cracked-machine/GatedMXREnvelopeFilter/docs/GatedEnvelopeFilter_Schematic.pdf

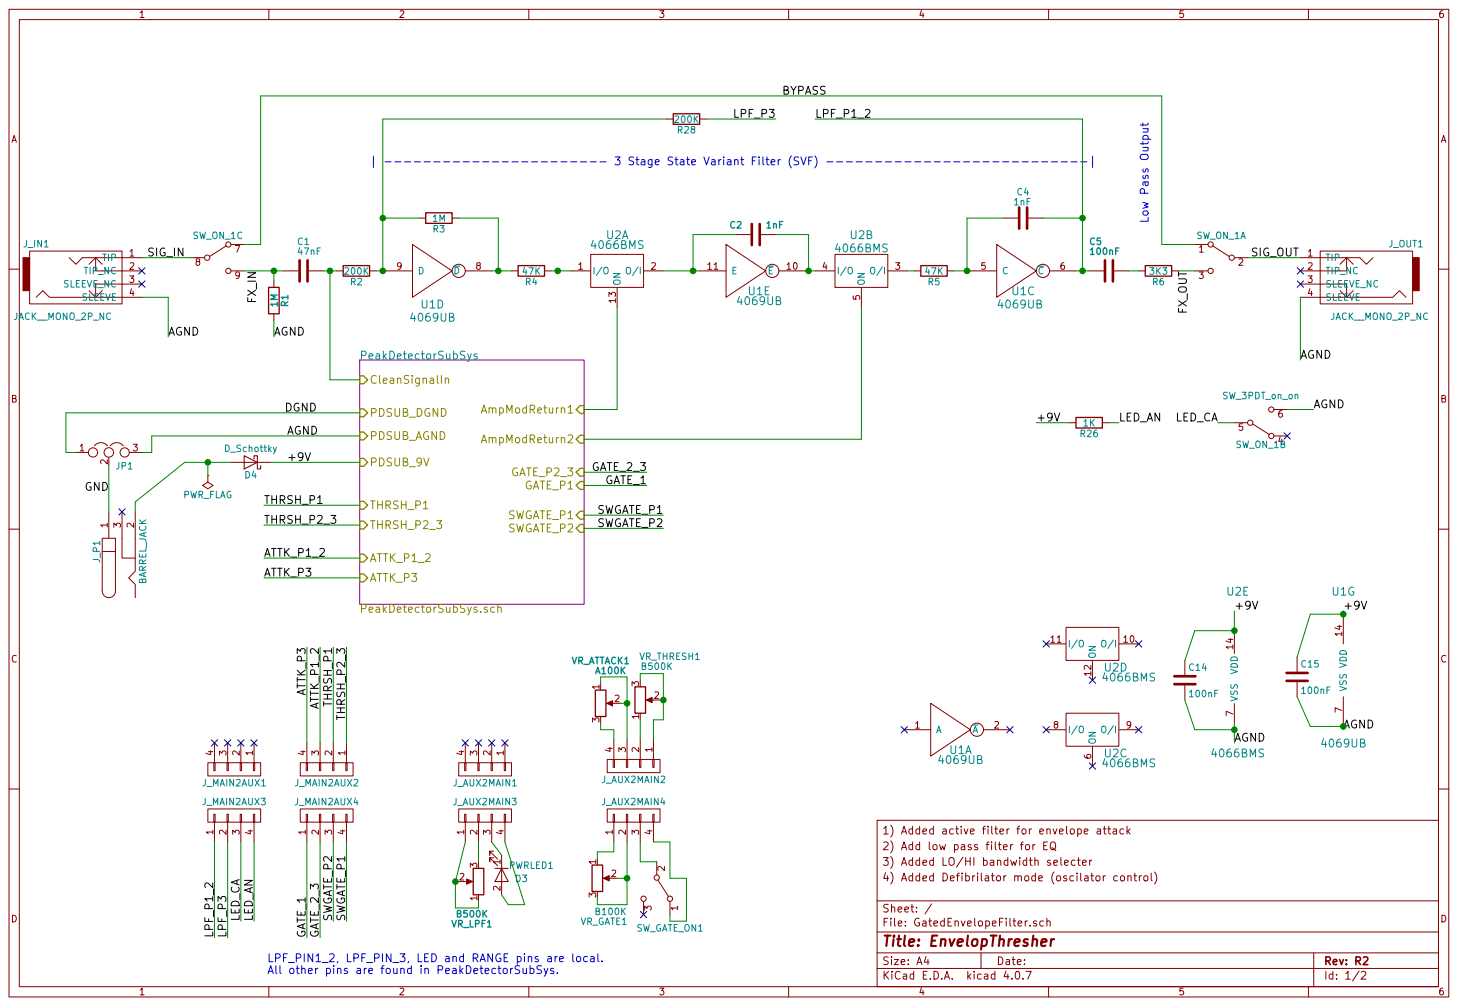
[picture p1: page 1]

1) Added active filter for envelope attack
2) Add low pass filter for EQ
3) Added LO/HI bandwidth selecter
File: GatedEnvelopeFilter.sch Sheet: / 4) Added Defibrilator mode (oscilator control)

LPF_PIN1_2, LPF_PIN_3, LED and RANGE pins are local.

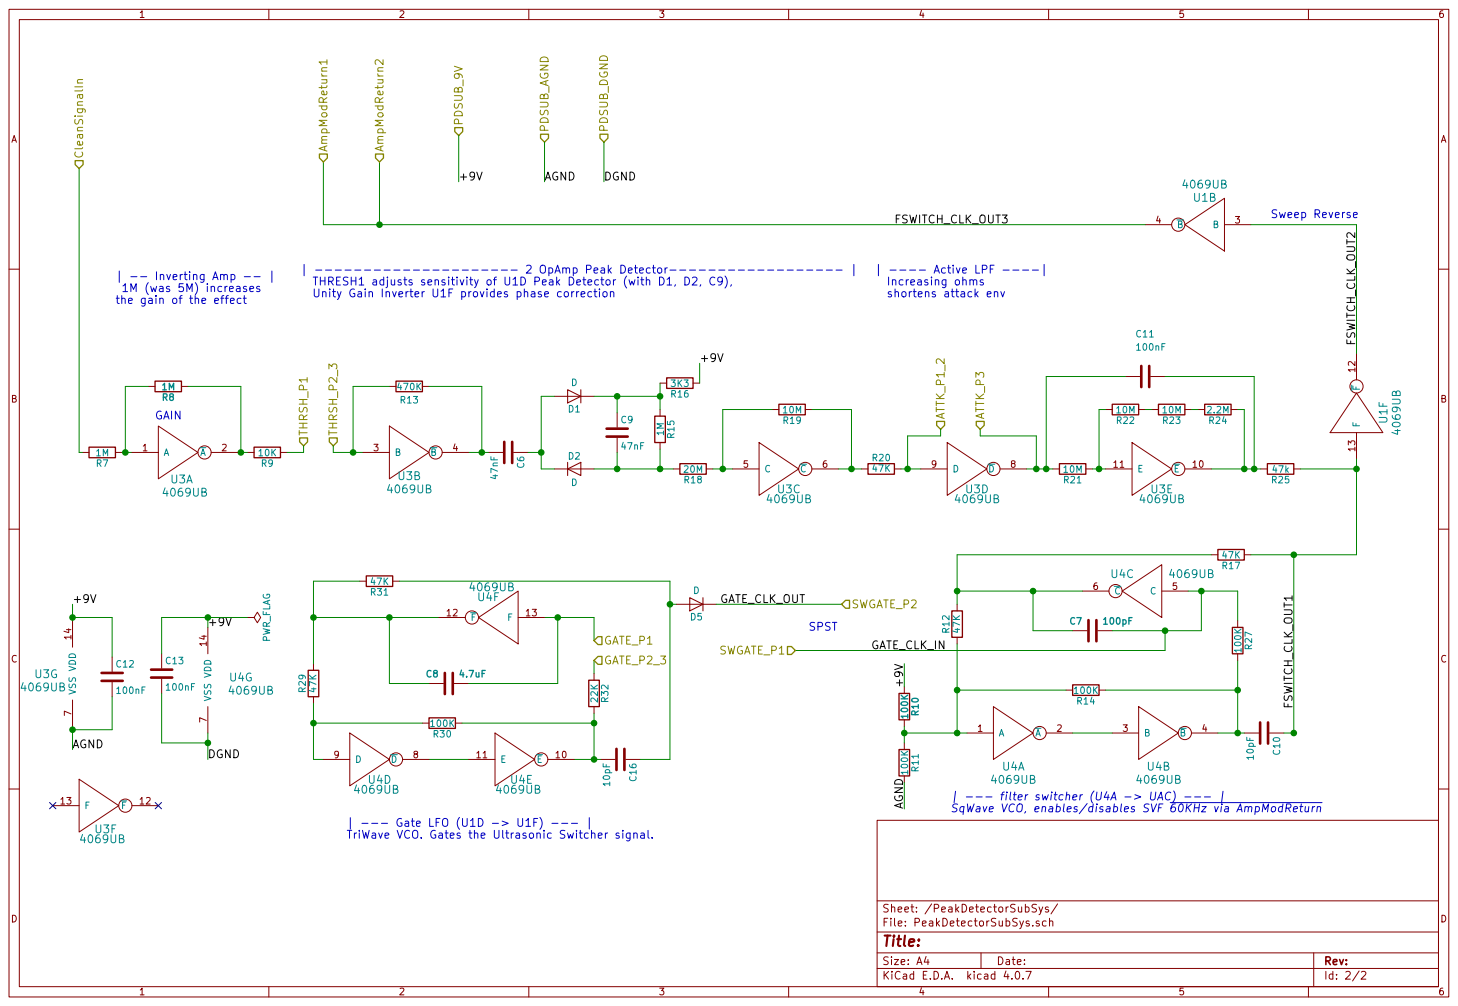
[picture p2: page 2]

-- Inverting Amp --
1M (was 5M) increases
the gain of the effect

--------------------- 2 OpAmp Peak Detector------------------
THRESH1 adjusts sensitivity of U1D Peak Detector (with D1, D2, C9),
Unity Gain Inverter U1F provides phase correction

--- filter switcher (U4A -> UAC) ---
SqWave VCO, enables/disables SVF 60KHz via AmpModReturn

--- Gate LFO (U1D -> U1F) ---
TriWave VCO. Gates the Ultrasonic Switcher signal.
