cracked-machine/GatedMXREnvelopeFilter/docs/GatedEnvelopeFilter-brdBack.pdf

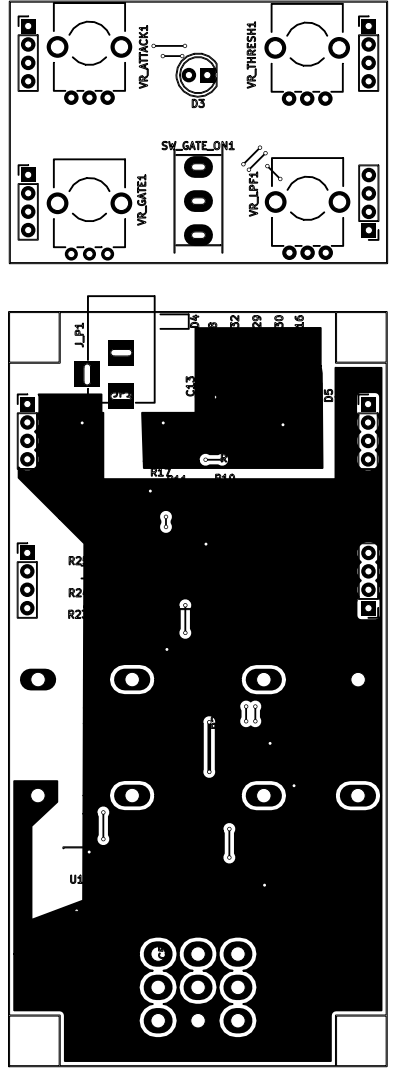
[picture p3: page 1]
