cracked-machine/GatedMXREnvelopeFilter/docs/GatedEnvelopeFilter-brdFront.pdf

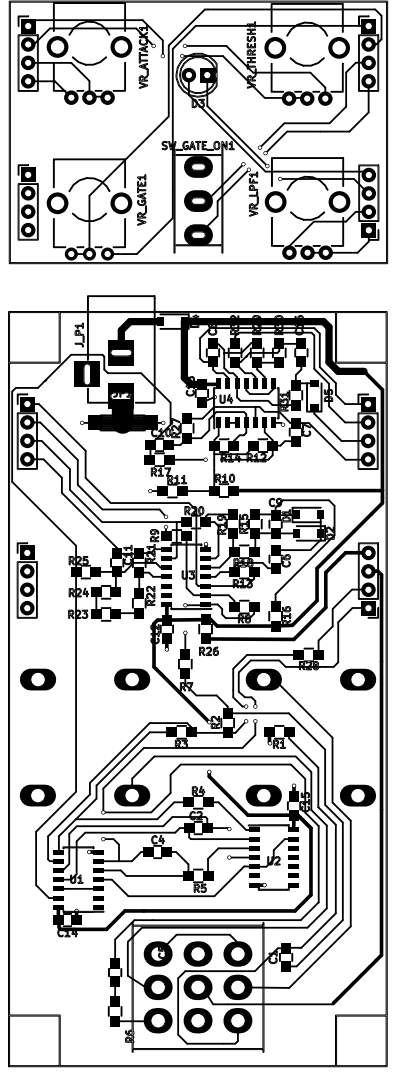
[picture p4: page 1]
