cracked-machine/GatedMXREnvelopeFilter/GatedEnvelopeFilter.kicad_pcb

## KiCad design GatedEnvelopeFilter.kicad_pcb (2018-03-17)

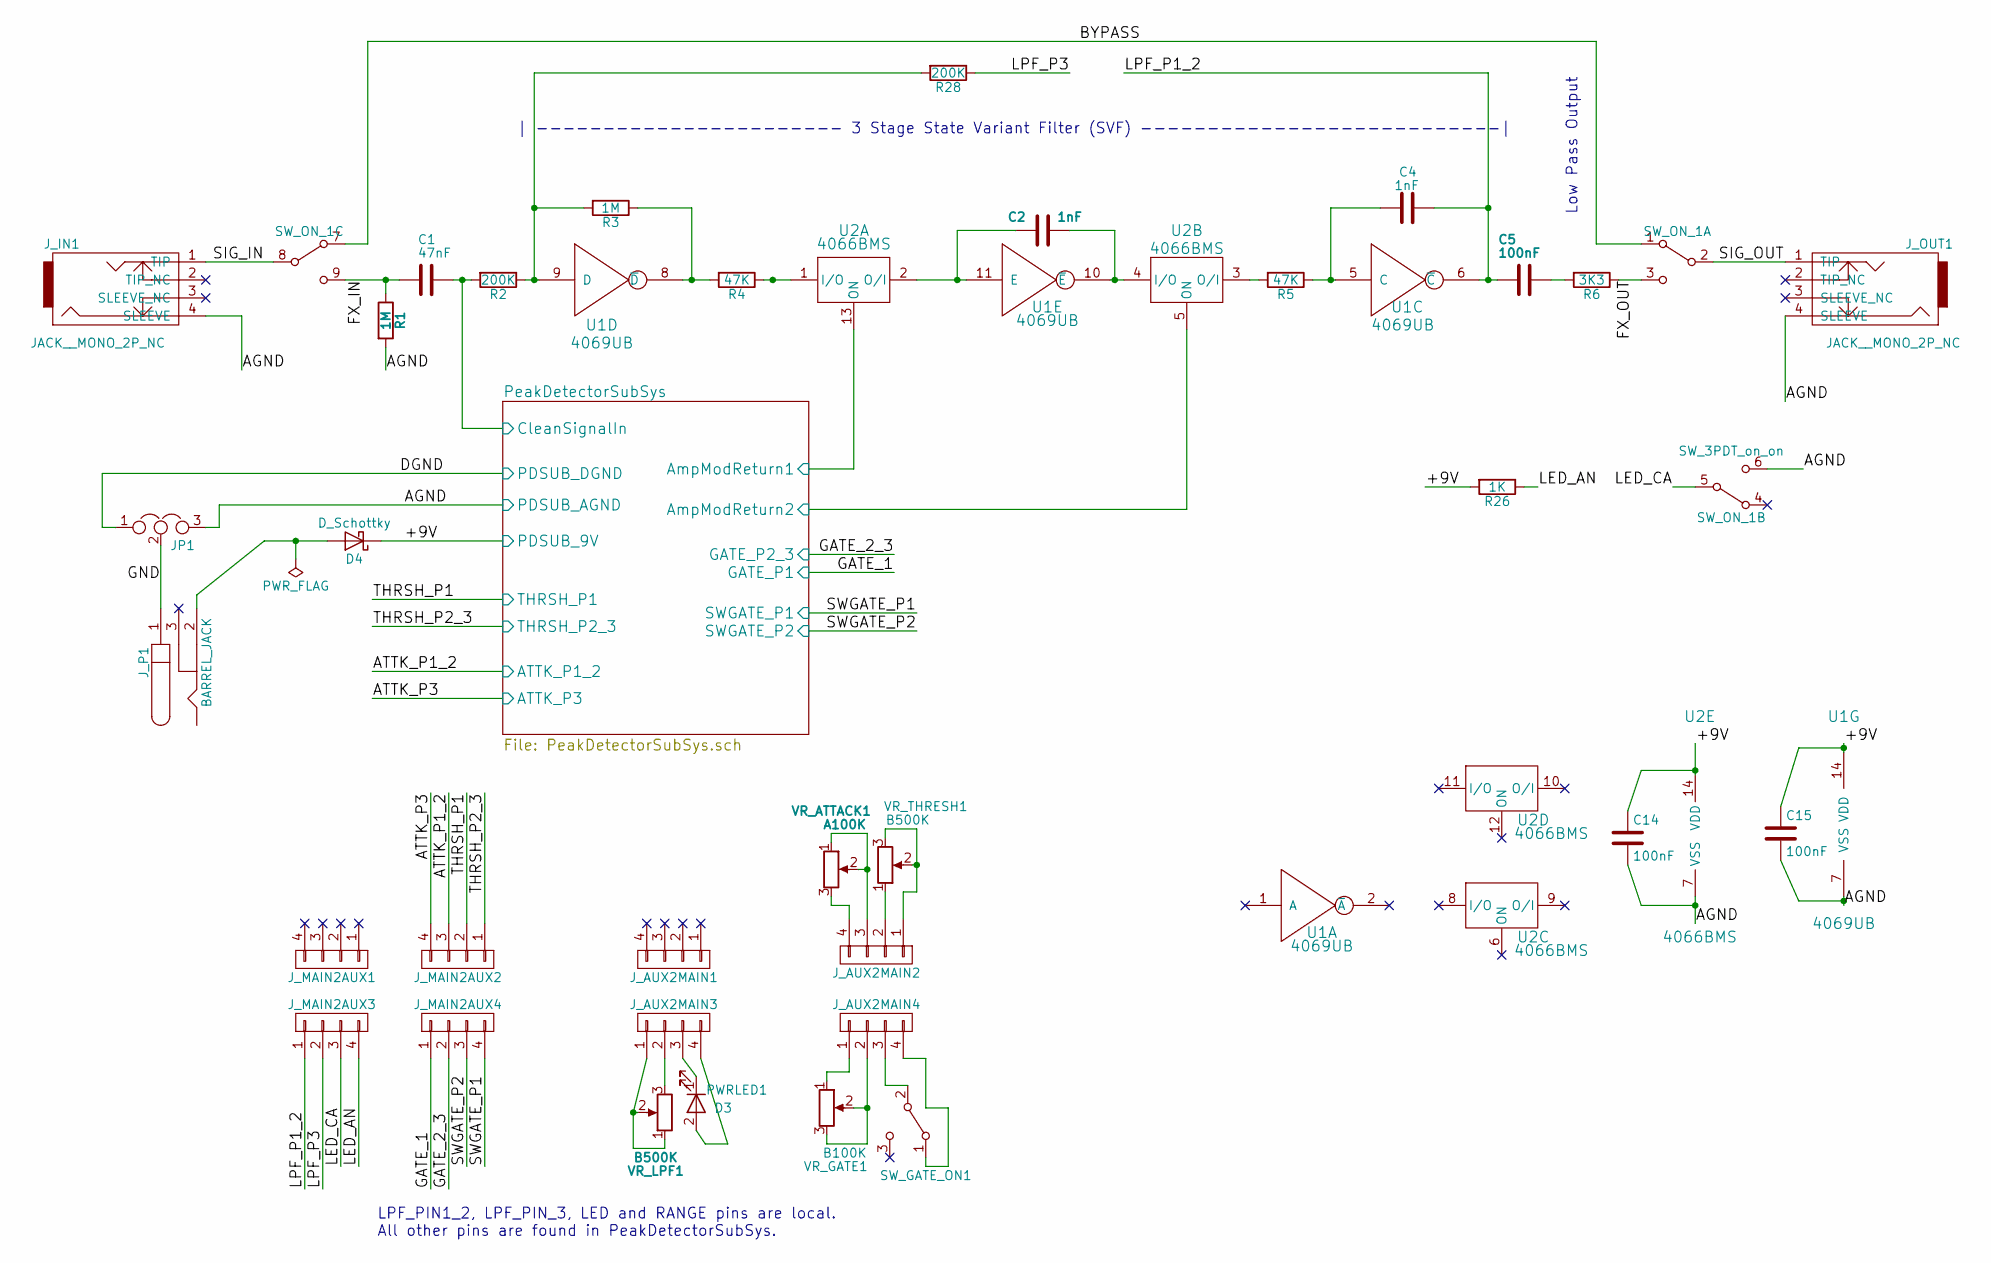
[picture p5: schematic GatedEnvelopeFilter.sch, EnvelopThresher]

Parts:
C1: 47nF; C_0805_HandSoldering
C2, C4: 1nF; C_0805_HandSoldering
C5, C14, C15: 100nF; C_0805_HandSoldering
D3: PWRLED1; LED_D5.0mm
D4: D_Schottky; D_SOD-123
JP1: Jumper_NC_Dual; NetTie-II_SMD
J_AUX2MAIN1, J_AUX2MAIN2, J_AUX2MAIN3, J_AUX2MAIN4: CONN_01X04; Pin_Header_Straight_1x04_Pitch2.54mm
J_IN1: JACK__MONO_2P_NC; NeutrikAudioSocket_Mono_PCB_NARROWPADS
J_MAIN2AUX1, J_MAIN2AUX2, J_MAIN2AUX3, J_MAIN2AUX4: CONN_01X04; Pin_Header_Straight_1x04_Pitch2.54mm
J_OUT1: JACK__MONO_2P_NC; NeutrikAudioSocket_Mono_PCB_NARROWPADS
J_P1: BARREL_JACK
R1, R3: 1M; R_0805_HandSoldering
R2, R28: 200K; R_0805_HandSoldering
R4, R5: 47K; R_0805_HandSoldering
R6: 3K3; R_0805_HandSoldering
R26: 1K; R_0805_HandSoldering
SW_GATE_ON1: SW_SPDT; SW_SPDT_W6.86MM_L12.7MM_P4.8MM_D2MM
SW_ON_1: SW_3PDT_on_on; SW_3PDT_W18MM_L17.3MM_P5.3MM_D2MM_SolderLugs
U1: 4069UB; SOIC-14_3.9x8.7mm_Pitch1.27mm
U2: 4066BMS; SOIC-14_3.9x8.7mm_Pitch1.27mm
VR_ATTACK1: A100K; Potentiometer_Bourns_PTV09A-1_Horizontal
VR_GATE1: B100K; Potentiometer_Bourns_PTV09A-1_Horizontal
VR_LPF1: B500K; Potentiometer_Bourns_PTV09A-1_Horizontal
VR_THRESH1: B500K; Potentiometer_Bourns_PTV09A-1_Horizontal

Connections:
/+9V: C14.1, C15.1, D4.1 (K), R26.2, U1.14 (VDD), U2.14 (VDD); also elsewhere on the board
/AGND: C14.2, C15.2, JP1.3, J_IN1.4 (SLEEVE), J_OUT1.4 (SLEEVE), R1.2, SW_ON_1.6 (C), U1.7 (VSS), U2.7 (VSS); also elsewhere on the board
/ATTK_P1_2: J_MAIN2AUX2.3; also elsewhere on the board
/ATTK_P3: J_MAIN2AUX2.4; also elsewhere on the board
/BYPASS: SW_ON_1.1 (A), SW_ON_1.7 (A)
/DGND: JP1.1; also elsewhere on the board
/FX_IN: C1.2, R1.1, SW_ON_1.9 (C)
/FX_OUT: R6.1, SW_ON_1.3 (C)
/GATE_1: J_MAIN2AUX4.1; also elsewhere on the board
/GATE_2_3: J_MAIN2AUX4.2; also elsewhere on the board
/GND: JP1.2, J_P1.1
/LED_AN: J_MAIN2AUX3.4, R26.1
/LED_CA: J_MAIN2AUX3.3, SW_ON_1.5 (B)
/LPF_P1_2: C4.1, C5.2, J_MAIN2AUX3.1, U1.6 (~C)
/LPF_P3: J_MAIN2AUX3.2, R28.1
/PeakDetectorSubSys/AmpModReturn1: U2.5 (ON), U2.13 (ON); also elsewhere on the board
/PeakDetectorSubSys/CleanSignalIn: C1.1, R2.2; also elsewhere on the board
/SIG_IN: J_IN1.1 (TIP), SW_ON_1.8 (B)
/SIG_OUT: J_OUT1.1 (TIP), SW_ON_1.2 (B)
/SWGATE_P1: J_MAIN2AUX4.4; also elsewhere on the board
/SWGATE_P2: J_MAIN2AUX4.3; also elsewhere on the board
/THRSH_P1: J_MAIN2AUX2.2; also elsewhere on the board
/THRSH_P2_3: J_MAIN2AUX2.1; also elsewhere on the board
unnamed: C2.1, U1.10 (~E), U2.4 (I/O)
unnamed: C2.2, U1.11 (E), U2.2 (O/I)
unnamed: C4.2, R5.1, U1.5 (C)
unnamed: C5.1, R6.2
unnamed: D3.1 (K), J_AUX2MAIN3.3
unnamed: D3.2 (A), J_AUX2MAIN3.4
unnamed: D4.2 (A), J_P1.2
unnamed: J_AUX2MAIN2.1, VR_THRESH1.2, VR_THRESH1.3
unnamed: J_AUX2MAIN2.2, VR_THRESH1.1
unnamed: J_AUX2MAIN2.3, VR_ATTACK1.1, VR_ATTACK1.2
unnamed: J_AUX2MAIN2.4, VR_ATTACK1.3
unnamed: J_AUX2MAIN3.1, VR_LPF1.1, VR_LPF1.2
unnamed: J_AUX2MAIN3.2, VR_LPF1.3
unnamed: J_AUX2MAIN4.1, VR_GATE1.1
unnamed: J_AUX2MAIN4.2, VR_GATE1.2, VR_GATE1.3
unnamed: J_AUX2MAIN4.3, SW_GATE_ON1.2 (B)
unnamed: J_AUX2MAIN4.4, SW_GATE_ON1.1 (A)
unnamed: R2.1, R3.2, R28.2, U1.9 (D)
unnamed: R3.1, R4.2, U1.8 (~D)
unnamed: R4.1, U2.1 (I/O)
unnamed: R5.2, U2.3 (O/I)

Notes on the sheet:
| ----------------------- 3 Stage State Variant Filter (SVF) ---------------------------|
Low Pass Output
LPF_PIN1_2, LPF_PIN_3, LED and RANGE pins are local. All other pins are found in PeakDetectorSubSys.

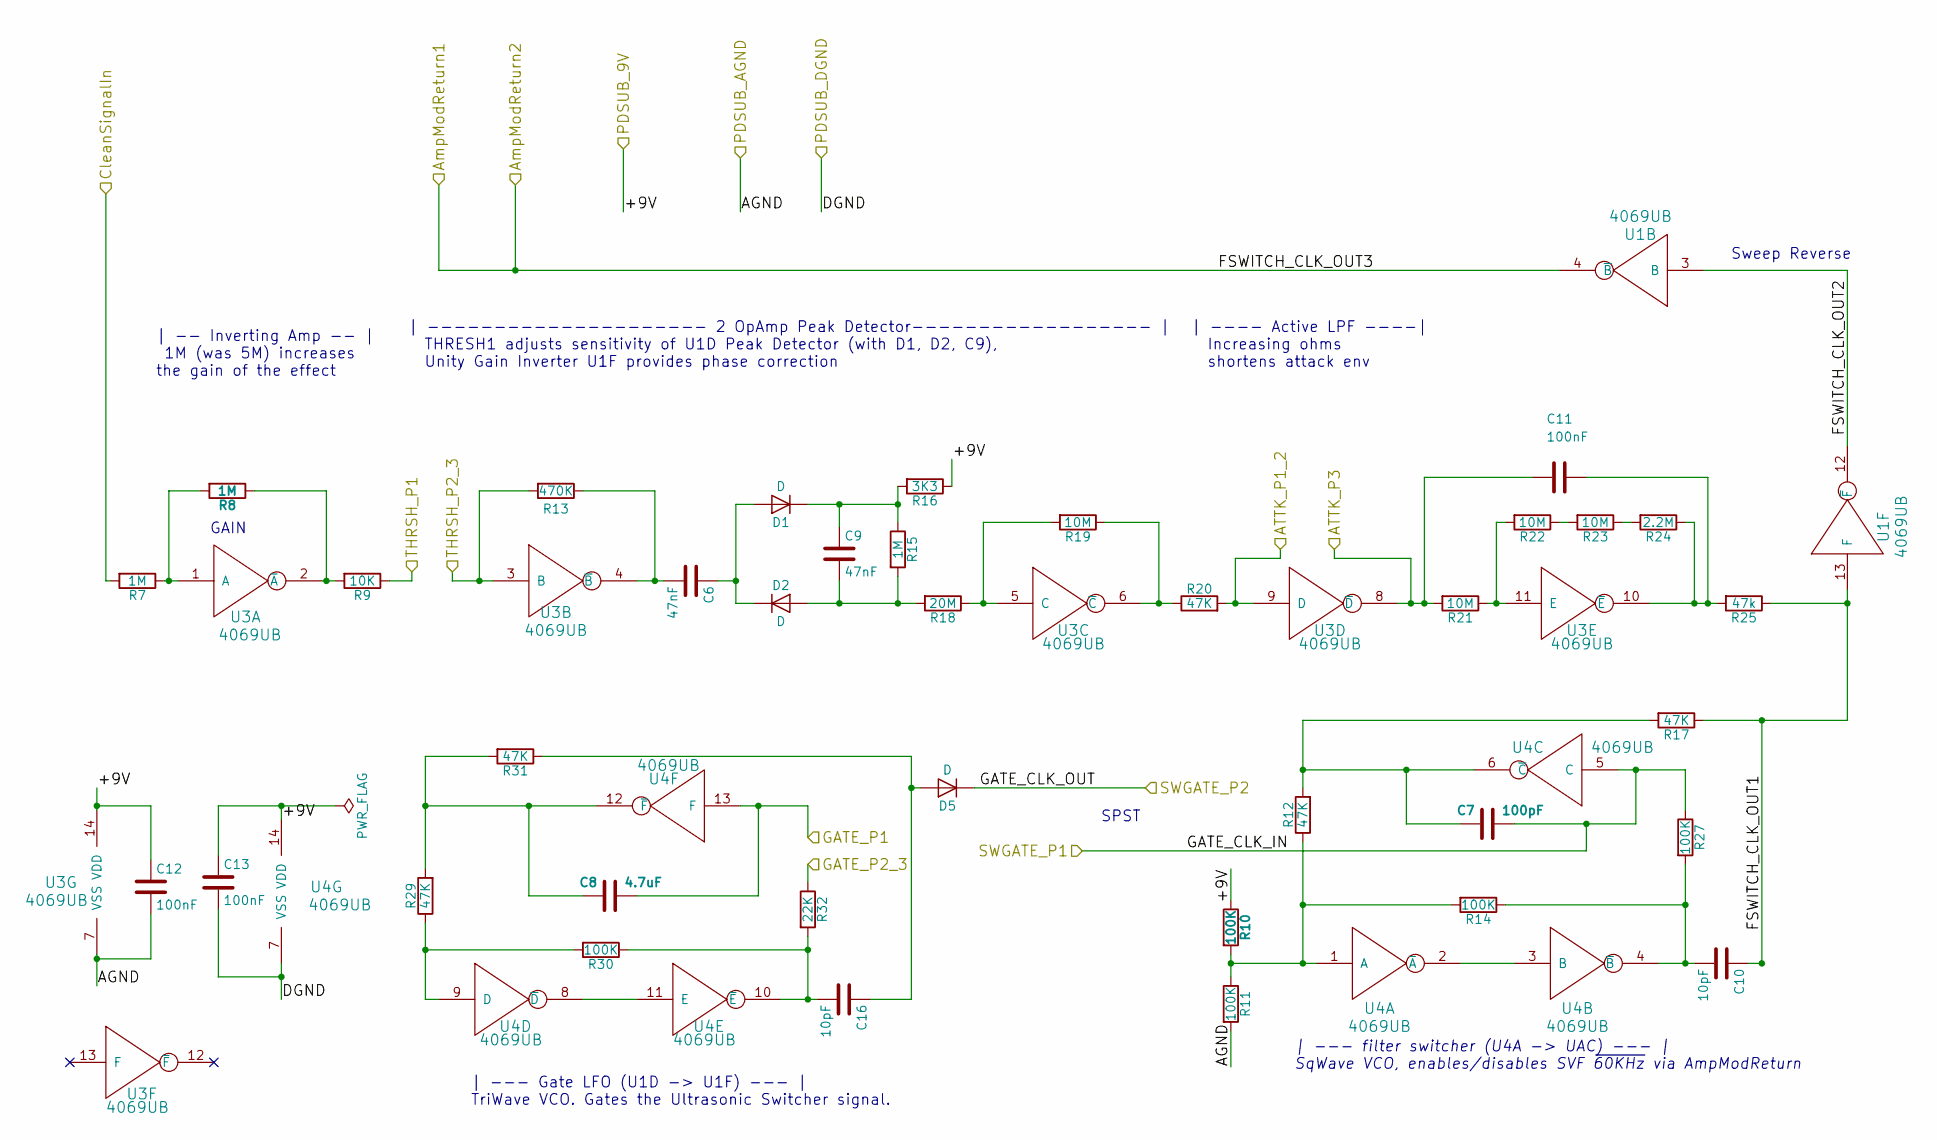
[picture p6: schematic PeakDetectorSubSys.sch]

Parts:
C6, C9: 47nF; C_0805_HandSoldering
C7: 100pF; C_0805_HandSoldering
C8: 4.7uF; C_0805_HandSoldering
C10, C16: 10pF; C_0805_HandSoldering
C11, C12, C13: 100nF; C_0805_HandSoldering
D1, D2, D5: D; D_SOD-123
R7, R8, R15: 1M; R_0805_HandSoldering
R9: 10K; R_0805_HandSoldering
R10, R11, R14, R27, R30: 100K; R_0805_HandSoldering
R12, R17, R20, R29, R31: 47K; R_0805_HandSoldering
R13: 470K; R_0805_HandSoldering
R16: 3K3; R_0805_HandSoldering
R18: 20M; R_0805_HandSoldering
R19, R21, R22, R23: 10M; R_0805_HandSoldering
R24: 2.2M; R_0805_HandSoldering
R25: 47k; R_0805_HandSoldering
R32: 22K; R_0805_HandSoldering
U1, U3, U4: 4069UB; SOIC-14_3.9x8.7mm_Pitch1.27mm

Connections:
/+9V: C12.1, C13.1, R10.1, R16.1, U3.14 (VDD), U4.14 (VDD); also elsewhere on the board
/AGND: C12.2, R11.2, U3.7 (VSS); also elsewhere on the board
/ATTK_P1_2: R20.2, U3.9 (D); also elsewhere on the board
/ATTK_P3: C11.2, R21.2, U3.8 (~D); also elsewhere on the board
/DGND: C13.2, U4.7 (VSS); also elsewhere on the board
/GATE_1: C8.1, U4.13 (F); also elsewhere on the board
/GATE_2_3: R32.1; also elsewhere on the board
/PeakDetectorSubSys/AmpModReturn1: U1.4 (~B); also elsewhere on the board
/PeakDetectorSubSys/CleanSignalIn: R7.2; also elsewhere on the board
/PeakDetectorSubSys/FSWITCH_CLK_OUT1: C10.1, R17.1, R25.1, U1.13 (F)
/PeakDetectorSubSys/FSWITCH_CLK_OUT2: U1.3 (B), U1.12 (~F)
/SWGATE_P1: C7.1, R27.1, U4.5 (C); also elsewhere on the board
/SWGATE_P2: D5.1 (K); also elsewhere on the board
/THRSH_P1: R9.1; also elsewhere on the board
/THRSH_P2_3: R13.2, U3.3 (B); also elsewhere on the board
unnamed: C6.1, D1.2 (A), D2.1 (K)
unnamed: C6.2, R13.1, U3.4 (~B)
unnamed: C7.2, R12.2, R17.2, U4.6 (~C)
unnamed: C8.2, R29.2, R31.2, U4.12 (~F)
unnamed: C9.1, D1.1 (K), R15.1, R16.2
unnamed: C9.2, D2.2 (A), R15.2, R18.2
unnamed: C10.2, R14.1, R27.2, U4.4 (~B)
unnamed: C11.1, R24.1, R25.2, U3.10 (~E)
unnamed: C16.1, D5.2 (A), R31.1
unnamed: C16.2, R30.1, R32.2, U4.10 (~E)
unnamed: R7.1, R8.2, U3.1 (A)
unnamed: R8.1, R9.2, U3.2 (~A)
unnamed: R10.2, R11.1, R12.1, R14.2, U4.1 (A)
unnamed: R18.1, R19.2, U3.5 (C)
unnamed: R19.1, R20.1, U3.6 (~C)
unnamed: R21.1, R22.2, U3.11 (E)
unnamed: R22.1, R23.2
unnamed: R23.1, R24.2
unnamed: R29.1, R30.2, U4.9 (D)
unnamed: U4.2 (~A), U4.3 (B)
unnamed: U4.8 (~D), U4.11 (E)

Notes on the sheet:
| ---- Active LPF ----| Increasing ohms shortens attack env
Sweep Reverse
| --------------------- 2 OpAmp Peak Detector------------------ | THRESH1 adjusts sensitivity of U1D Peak Detector (with D1, D2, C9), Unity Gain Inverter U1F provides phase correction
| --- filter switcher (U4A -> UAC) --- | SqWave VCO, enables/disables SVF ~60KHz via AmpModReturn
| -- Inverting Amp -- | 1M (was 5M) increases the gain of the effect
GAIN
| --- Gate LFO (U1D -> U1F) --- | TriWave VCO. Gates the Ultrasonic Switcher signal.
SPST

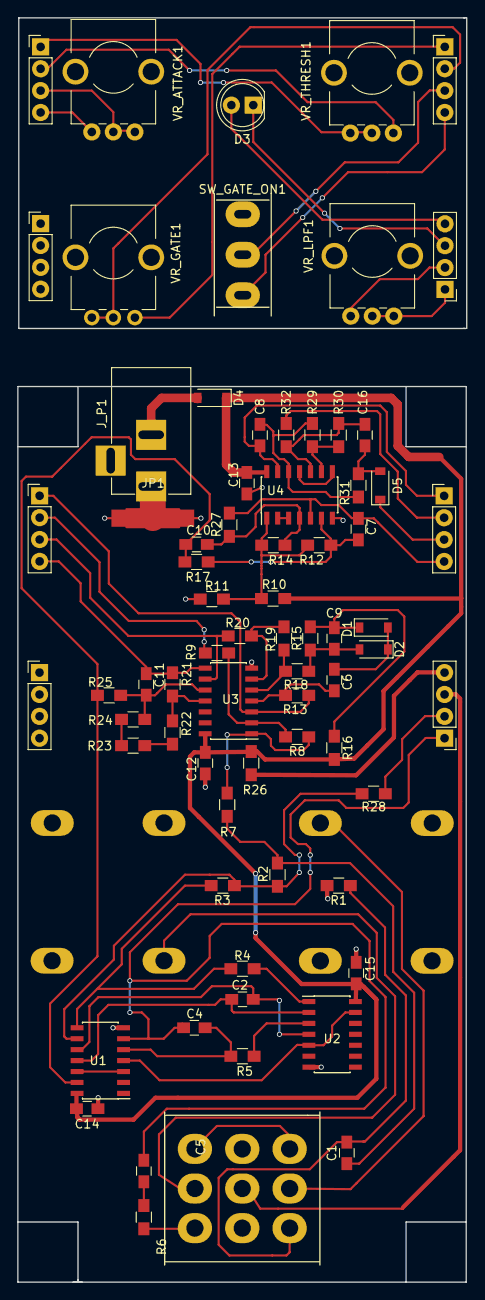
[picture p7: board GatedEnvelopeFilter.kicad_pcb from above]

Board: 2 copper layers, 52.1 x 104.0 mm, 74 parts (0 on the bottom side), 67 nets.
