cracked-machine/GatedMXREnvelopeFilter/(commit log)

2018-03-17 First Upload
    [GatedEnvelopeFilter-B.Cu.gbr, GatedEnvelopeFilter-B.Mask.gbr, GatedEnvelopeFilter-B.SilkS.gbr, GatedEnvelopeFilter-Edge.Cuts.gbr, GatedEnvelopeFilter-F.Cu.gbr, GatedEnvelopeFilter-F.Mask.gbr, GatedEnvelopeFilter-F.SilkS.gbr, GatedEnvelopeFilter.drl]
2018-03-25 Added output level pot control
    [GatedEnvelopeFilter.sch]
